mark-helwig/HCRL_Draco3_PCBs/FT Sensor Amplifier Board/KiCADv6/MSOP-10_MS_LIT.step

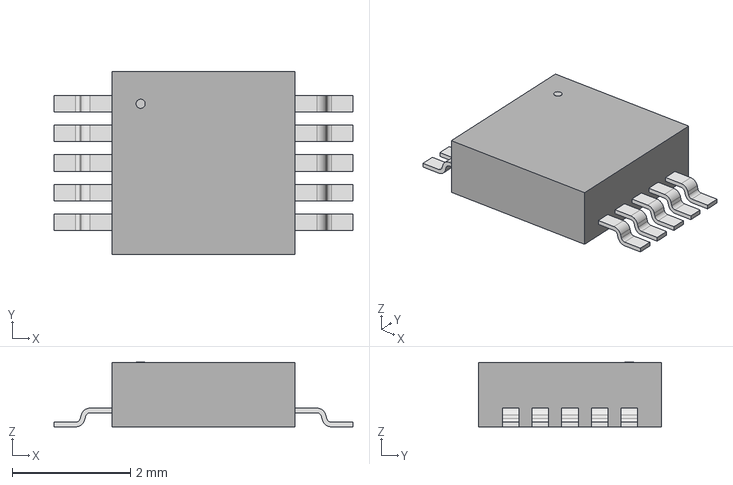
[picture p1: CAD file, 2024-12-06]
FT Sensor Amplifier Board/KiCADv6/MSOP-10_MS_LIT.step
5.05 x 3.10 x 1.09 mm
