mark-helwig/HCRL_Draco3_PCBs/FT Sensor Amplifier Board/KiCADv6/5055780261.stp

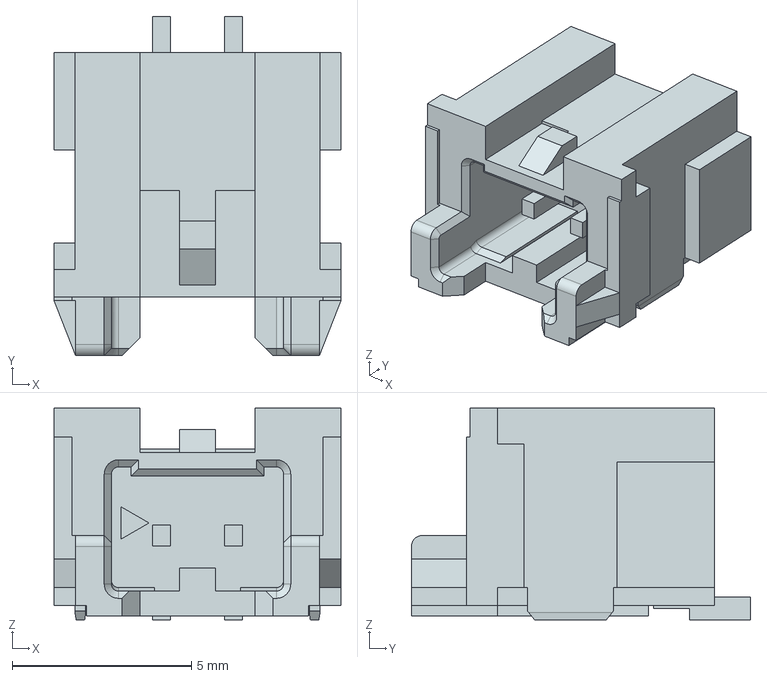
[picture p2: CAD file, 2024-12-06]
FT Sensor Amplifier Board/KiCADv6/5055780261.stp
8.00 x 9.45 x 5.90 mm
