mark-helwig/HCRL_Draco3_PCBs/(commit log)

2024-12-06 Initial Board Draft -- No silkscreen
    [5055780261.stp, AmpSchem.kicad_sch, Draco_FT_Amp_2024.kicad_pcb, Draco_FT_Amp_2024.kicad_sch, MSOP-10_MS_LIT.step]
2024-12-07 silkscreen values added
    [Draco_FT_Amp_2024.kicad_pcb, Draco_FT_Amp_2024.kicad_sch]
